speedcontrols/ac_sc_grinder/doc/README.md

## Content

- **[assembly.md](assembly.md)** - build manual.
- **[troubleshooting.md](troubleshooting.md)** - if something goes wrong.
- **[development.md](development.md)** - development & components replacement info.
- **[math.md](./math.md)** - algorithms description.
