speedcontrols/ac_sc_grinder/hal/stm32f103c8/stm32cube/README.md

Content of this folder is generated by STM32CubeMX from applied `.ioc` file.
Don't edit anything by hand!
