speedcontrols/ac_sc_grinder/doc/data/models/README.md

Scilab model of grinder motor
=============================

Model to test the formula for calculating the motor speed.

How to use:

1. Run Scilab (6.0)
2. Open `main_script.sce`
3. Set model parameters in `main_script.sce`
4. Run `main_script.sce`
5. Estimate the speed calculation error on the plot
6. Calculated speed value is also printed to the Scilab console
