speedcontrols/ac_sc_grinder/doc/images/lcsc_import.png

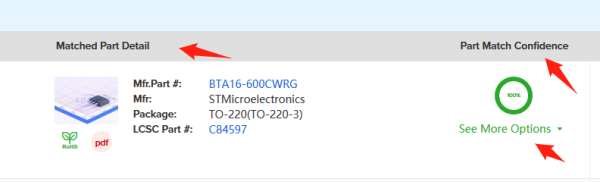
doc/images/lcsc_import.png
