speedcontrols/ac_sc_grinder/doc/images/pcb_and_case.jpg

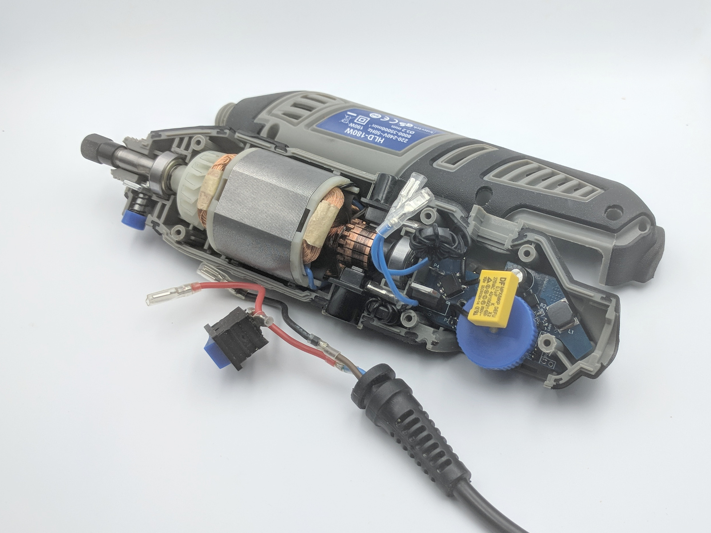
doc/images/pcb_and_case.jpg
