speedcontrols/ac_sc_grinder/doc/images/pcb_bottom.jpg

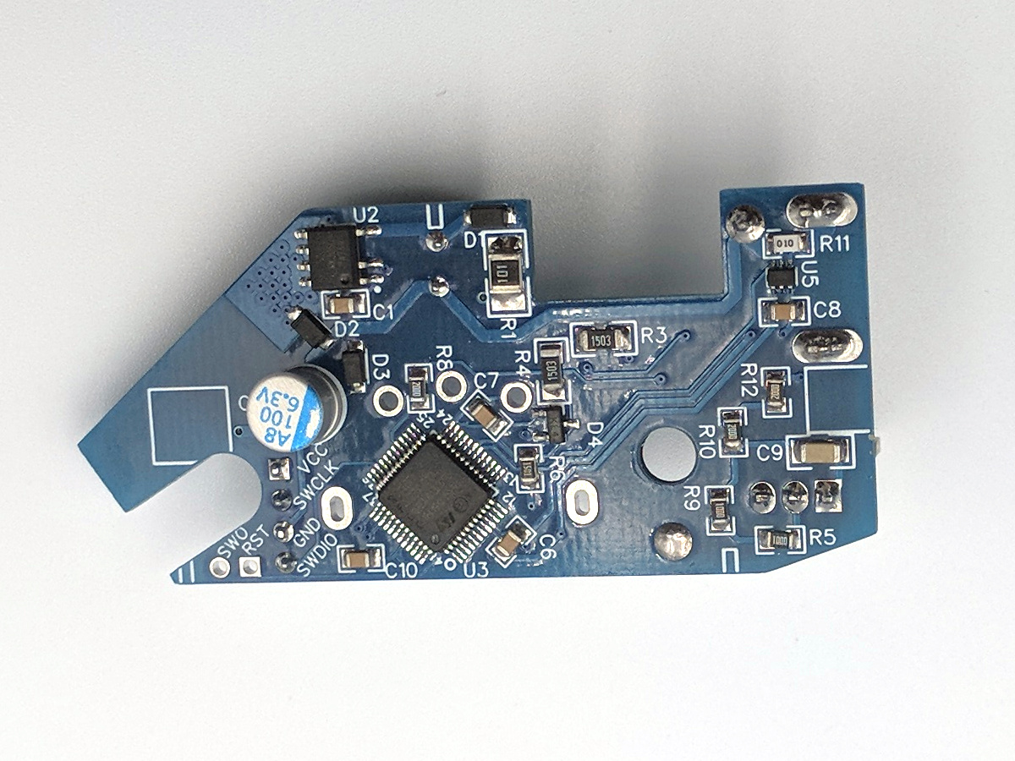
doc/images/pcb_bottom.jpg
