speedcontrols/ac_sc_grinder/doc/images/pcb_full.jpg

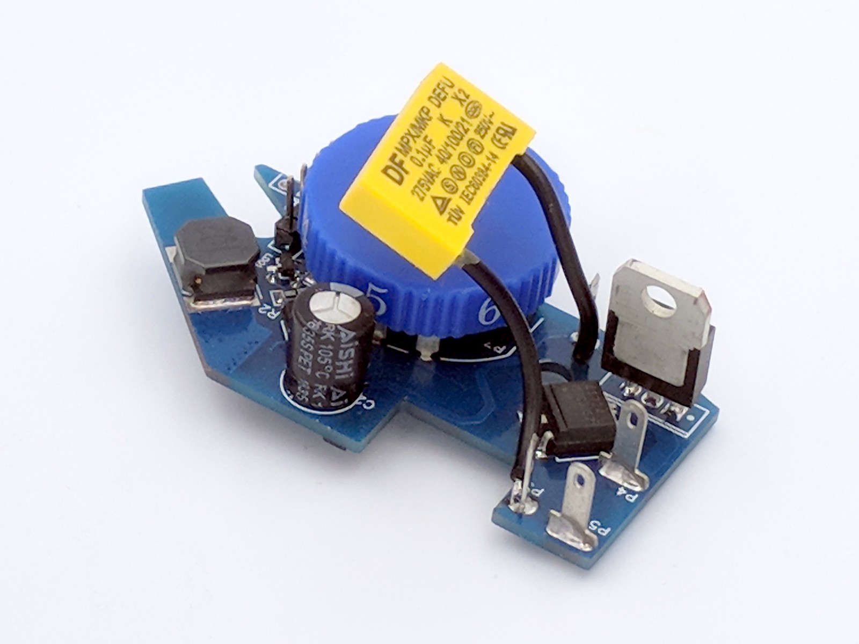
doc/images/pcb_full.jpg
