speedcontrols/ac_sc_grinder/doc/images/pcb_top.jpg

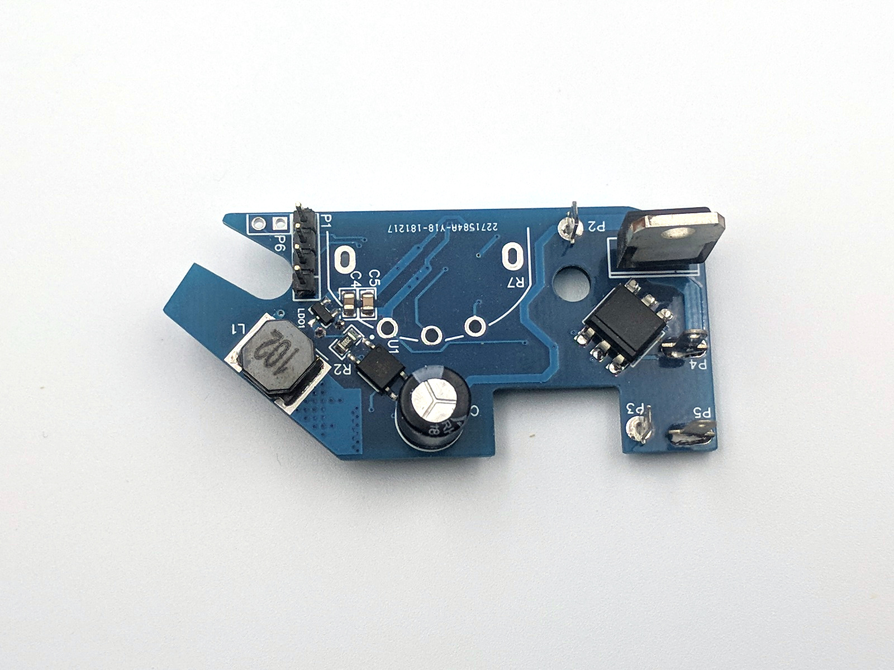
doc/images/pcb_top.jpg
