speedcontrols/ac_sc_grinder/doc/assembly.md

Device assembly <!-- omit in toc -->
===============

- [Supported grinders & PCBs](#supported-grinders--pcbs)
  - [Newacalox (red)](#newacalox-red)
  - [BDCAT (curved)](#bdcat-curved)
  - [Hilda 180W (gray) and similar](#hilda-180w-gray-and-similar)
- [Required components](#required-components)
- [Extract some parts from original board](#extract-some-parts-from-original-board)
- [Solder PCB top and bottom](#solder-pcb-top-and-bottom)
- [Cleanup PCB](#cleanup-pcb)
- [Install the rest and attach wires](#install-the-rest-and-attach-wires)
- [Upload firmware and test](#upload-firmware-and-test)
- [Cover PCB with protective coating](#cover-pcb-with-protective-coating)
- [Firmware tune](#firmware-tune)

## Supported grinders & PCBs

If you wish to customize this project, or join development, see
[dev notes](development.md).

### Newacalox (red)

- [link](https://www.aliexpress.com/item/32847620840.html)

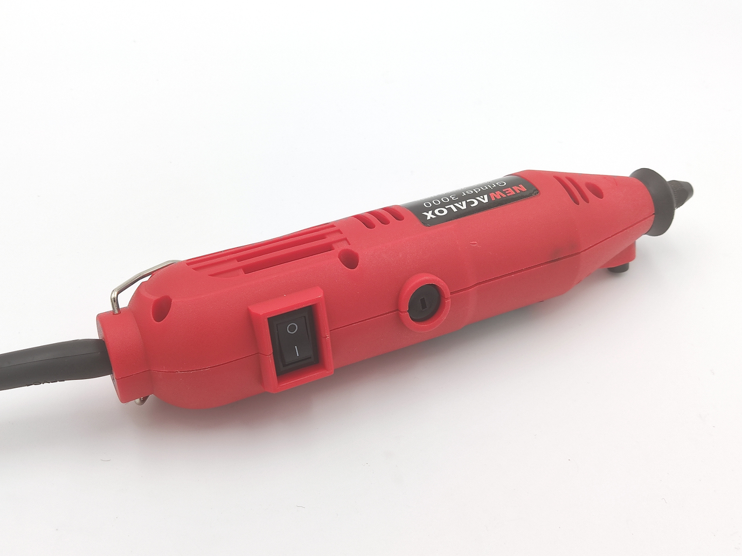
[picture p6: doc/images/grinder_newacalox.jpg]


Warning! Don't buy aqua grinders with horizontal switch placement. Those are
very similar, but need different PCB inside

PCB:

- [v4 board](https://easyeda.com/speed/ac-speed-control-v4)

### BDCAT (curved)

- [link](https://www.aliexpress.com/item/33060990933.html)

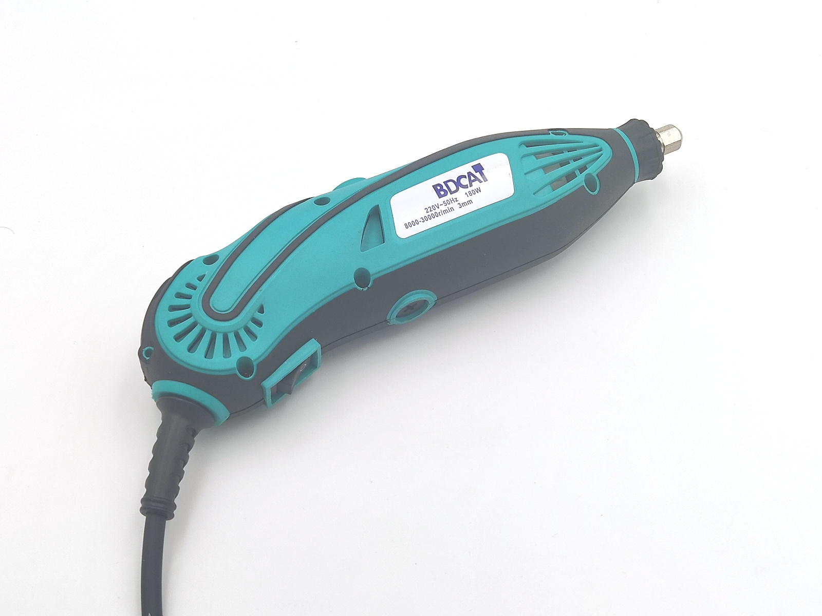
[picture p7: doc/images/grinder_bdcat.jpg]


PCB:

- [v4 board](https://easyeda.com/speed/ac-speed-control-v4)

### Hilda 180W (gray) and similar

Warning! Those grinders are out of market and not recommended for use.

- [link1](https://www.aliexpress.com/af/hilda-180w.html?SortType=total_tranpro_desc)
- [link2](https://www.banggood.com/40Pcs-180W-230V-Electric-Hand-Drill-Rotary-Tool-Mini-Electric-Grinder-Cutting-Polishing-Tools-p-1291185.html)

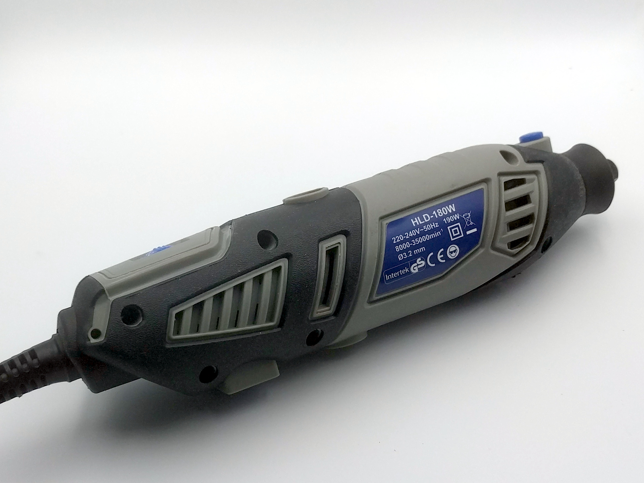
[picture p8: doc/images/grinder_hilda.jpg]


PCB:

- [v1 board](https://easyeda.com/speed/AC-speed-control-for-grinder)
- [v2 development board](https://easyeda.com/speed/ac-speed-control-v2-dev) (has
  additional interfaces, used by developers to prototype new features)

## Required components

\- | Name | Comment
-----|-------------|--------
1 | Grinder mini drill | See links above.
2 | PCB & Components | See links above, acording to your model. If you order PCB first, components second, you will be able to join delivery and save some bucks.
3 | PCB protective coating | [Plastik 70 CRC](https://www.google.com/search?q=Plastik+70+CRC) or any other acrylic [insulating lacquer](https://www.google.com/search?q=insulating+lacquer).
4 | [Male](https://www.aliexpress.com/item/32823098492.html) & [female](https://www.aliexpress.com/item/32978811645.html) 2.8x0.5mm power terminals | Optional. You can solder power wires directly.
5 | [22 AWG wire](https://www.aliexpress.com/item/1005002194439398.html) | Stainless steel / Nichrome / ... (any not too soft), for SMT stencil only. Position paste mask over PCB, via reference holes.
6 | [Cheap ST-link/V2 programmer](https://www.aliexpress.com/af/st-link-v2.html?SortType=total_tranpro_desc) | Only for boards without USB connector. You can also order it at [LCSC](https://lcsc.com/search?q=st-link) with other components.

Note, if you have soldering air gun, it's good idea to order SMT stencil to
simplify assembly. Select custom stencil, size 70*50mm & bottom layer only.

**Important!** If you order SMT stencil, add text note to your order: "**make
stencil according to paste mask file and don't forget corner holes**".

## Extract some parts from original board

Prior to disassemble, turn grinder on for 5 minutes to run-in brushes. That
will make following calibration more stable.

You need:

- Potentiometer.
- Motor terminals (optional).
- Tiac (optional, if Z0409).

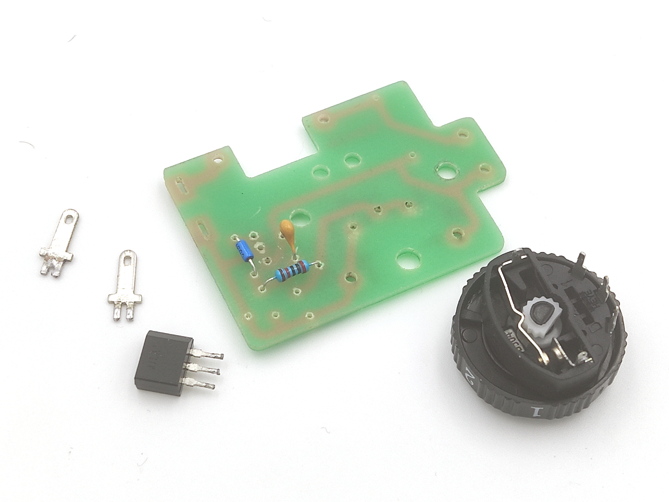
[picture p9: doc/images/old_pcb_components_newacalox.jpg]
Reused components from original Newacalox board
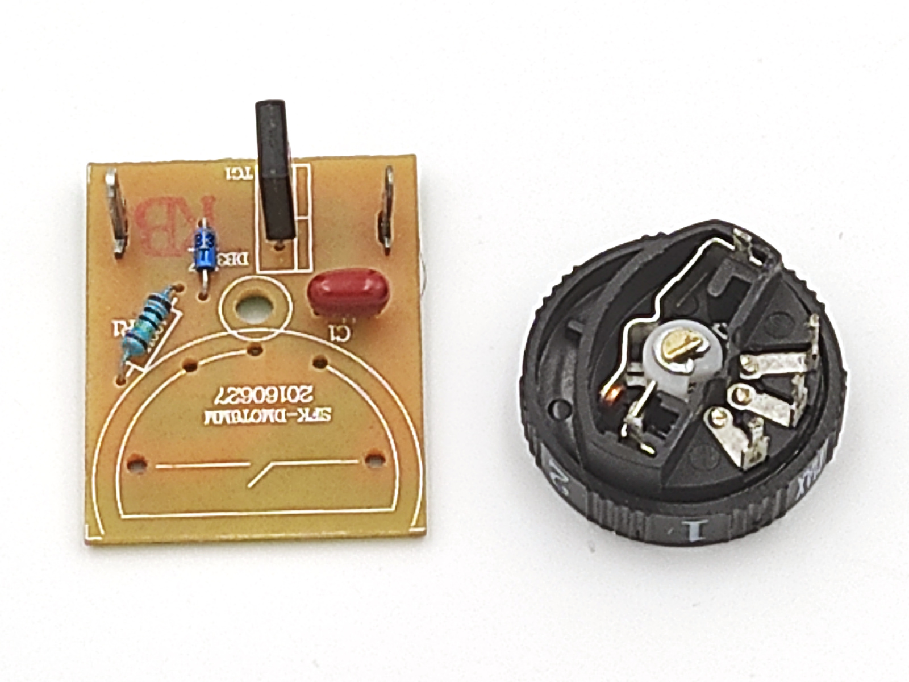
[picture p10: doc/images/old_pcb_components_bdcat.jpg]
Reused components from original BDCAT board
 

## Solder PCB top and bottom

We recommend to install all components, except regulating knob. Because on
flux cleanup phase, some solvents can wash off speed marks.

PCB bottom (Newacalox & BDCAT):

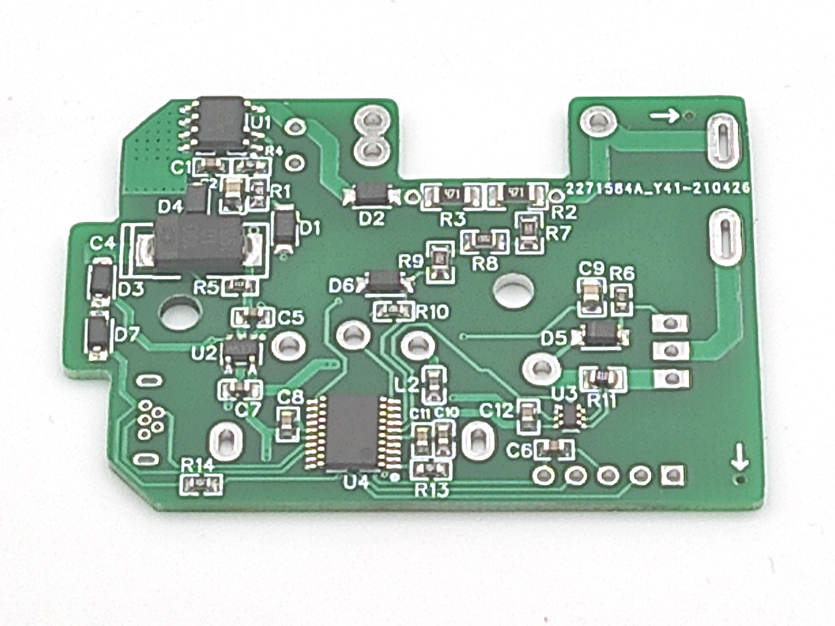
[picture p11: doc/images/pcb_v4_newacalox_bottom.jpg]
PCB bottom side (Newacalox)
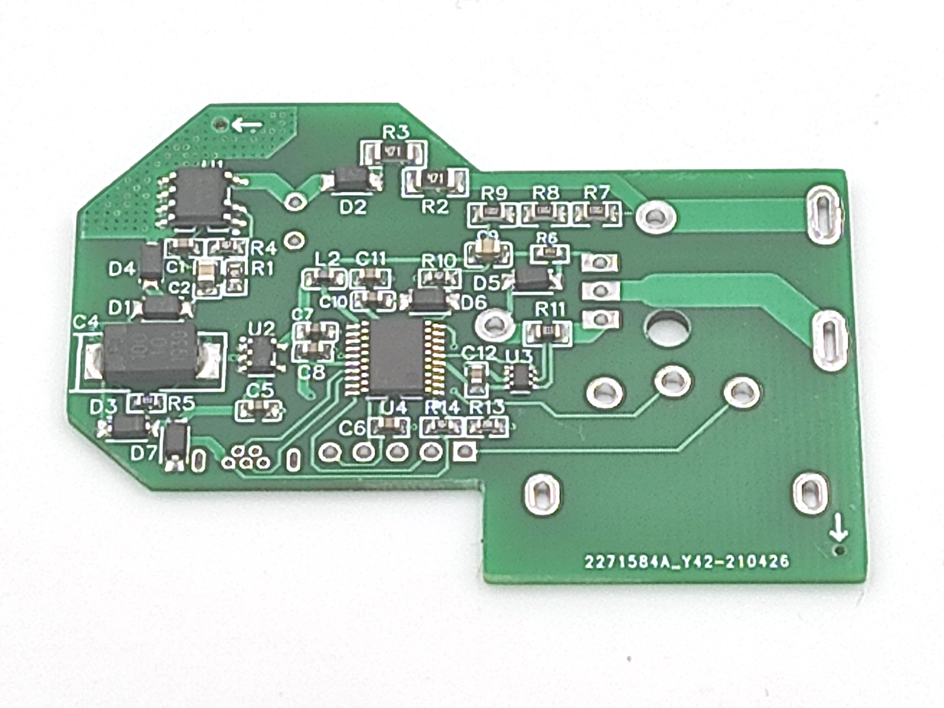
[picture p12: doc/images/pcb_v4_bdcat_bottom.jpg]
PCB bottom side (BDCAT)
 

PCB top (Newacalox & BDCAT):

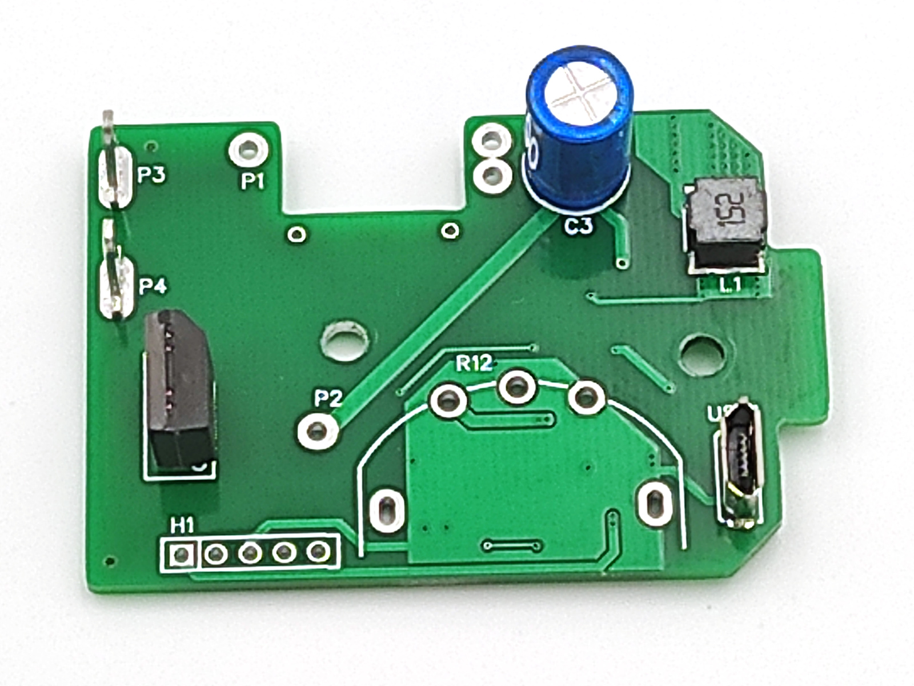
[picture p13: doc/images/pcb_v4_newacalox_top.jpg]
PCB top side (Newacalox)
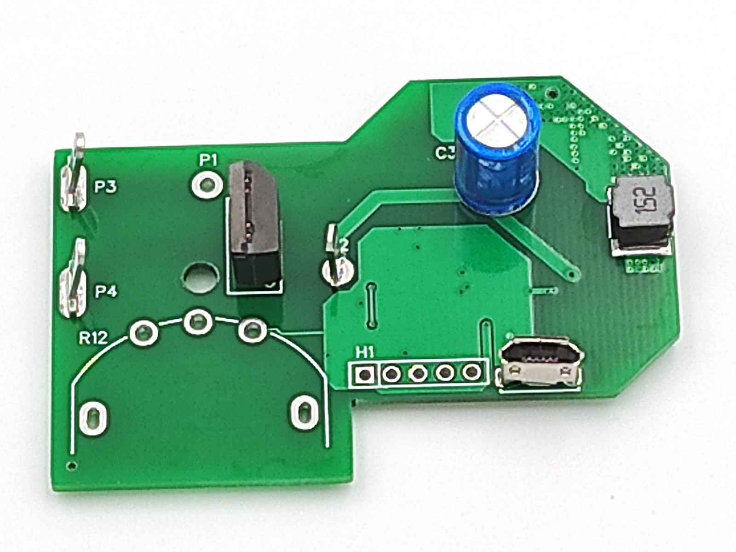
[picture p14: doc/images/pcb_v4_bdcat_top.jpg]
PCB top side (BDCAT)
 

## Cleanup PCB

You should remove the rest of flux, to add protective coating later. We recommend
use ultrasonic bath (small ones are cheap).

## Install the rest and attach wires

Now you can install potentiometer, and check everything fits into case.
Don't forget to remove flux again.

PCB with speed knob:

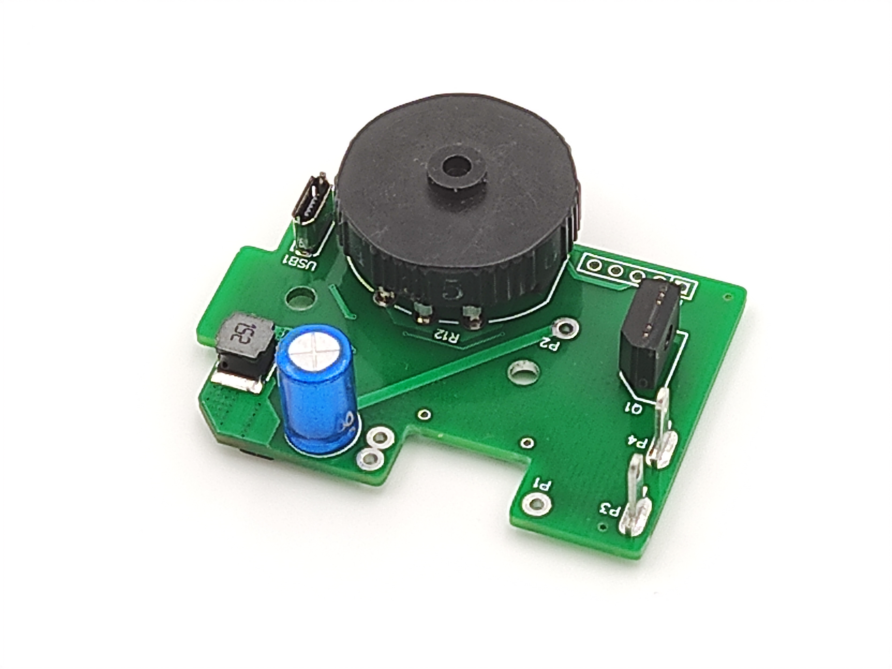
[picture p15: doc/images/pcb_v4_newacalox_full.jpg]
PCB with all components (Newacalox)
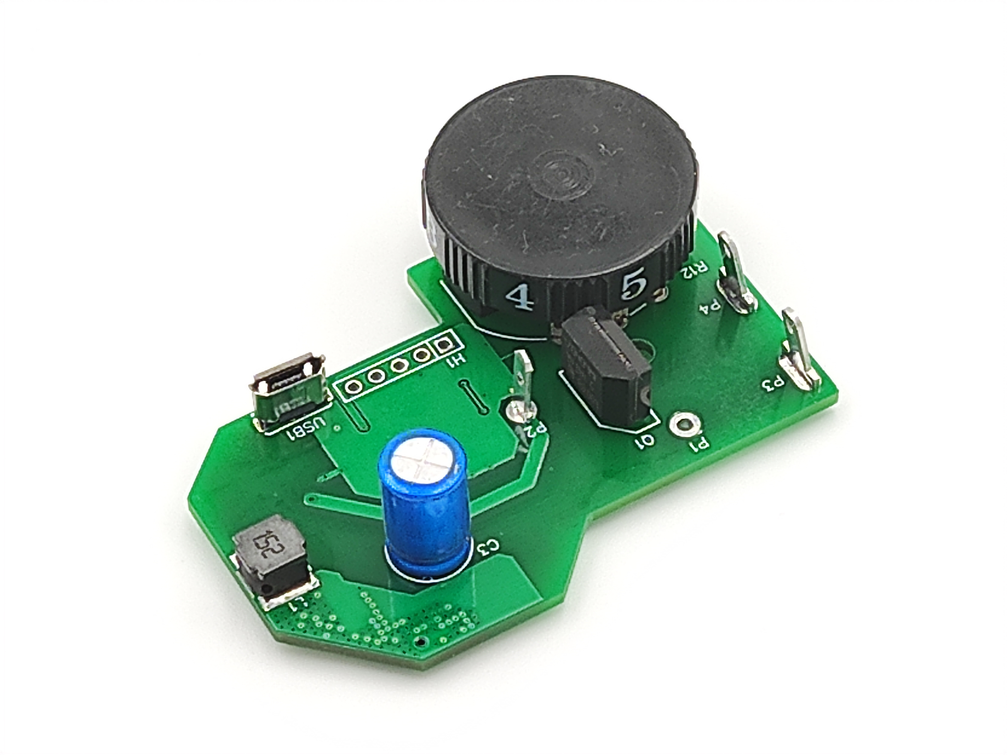
[picture p16: doc/images/pcb_v4_bdcat_full.jpg]
PCB with all components (BDCAT)
 

PCB in drill body:

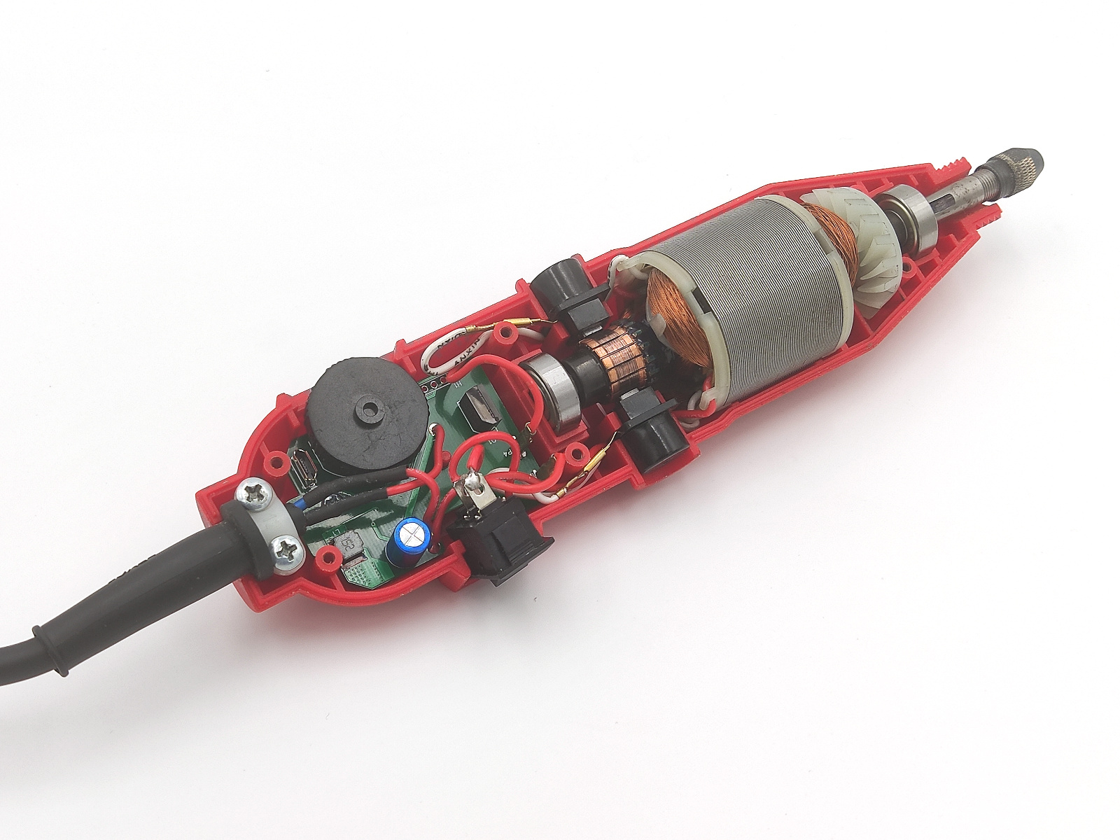
[picture p17: doc/images/pcv_v4_in_case_newacalox.jpg]
PCB in case
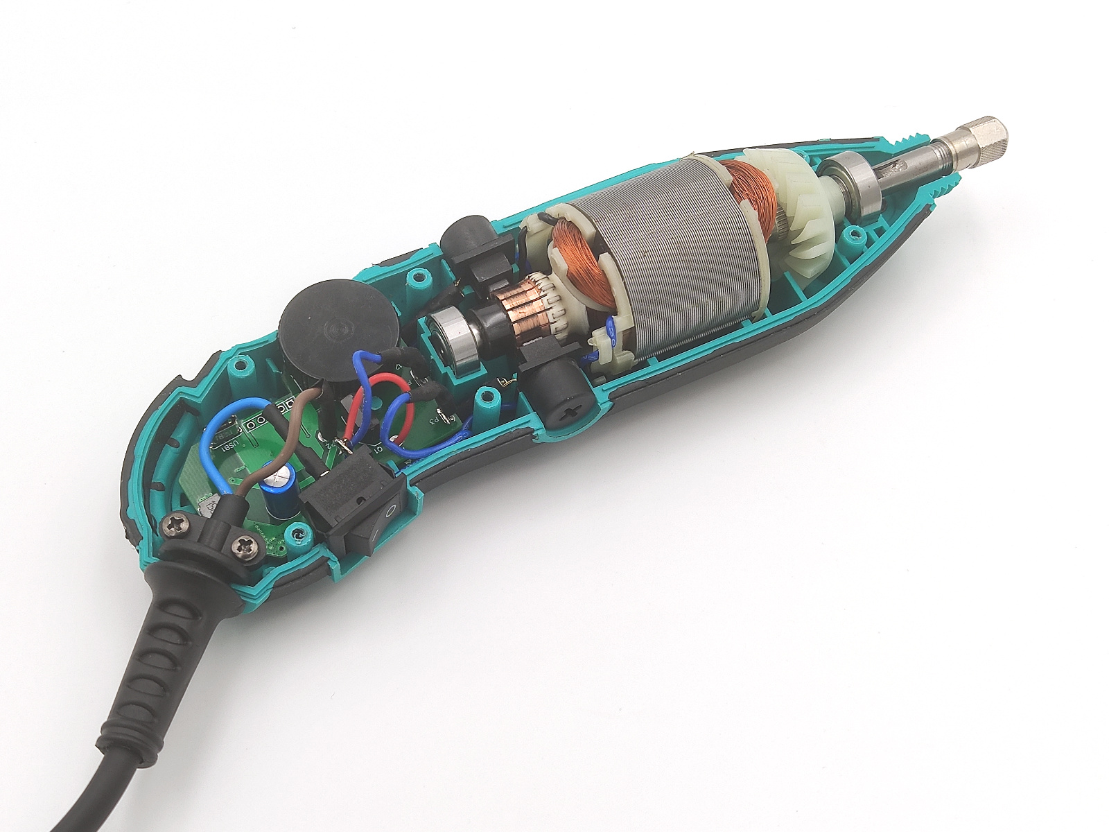
[picture p18: doc/images/pcv_v4_in_case_bdcat.jpg]
PCB in case
 

## Upload firmware and test

**WARNING! You MUST unplug power cord prior to firmware upload.** Turning power
off via grinder switch is not enough. If you plug programmer into computer
while AC plug in power socket, your USB interface may be damaged!

1. Install [VS Code](https://code.visualstudio.com/).
2. Clone this repo or download as zip archive and unpack somewhere.
3. Open folder with project AND after VS Code suggests to install plugins - agree
   with everything. That should install PlatformIO and all required dependencies.
4. Make sure you installed & configured ST-link/V2 drivers:
   - [Linux](http://docs.platformio.org/en/latest/installation.html#troubleshooting)
     instructions (how to configure `udev` rules).
   - [Windows](https://www.st.com/en/development-tools/stsw-link009.html) drivers.
5. Attach USB cable or ST-link/V2 programmer (depends on your board).
6. In VS Code, click PlatformIO tab, expand `env:...` item with matching
   MCU/programmer and click `Upload` (see image blow). Then wait until complete.

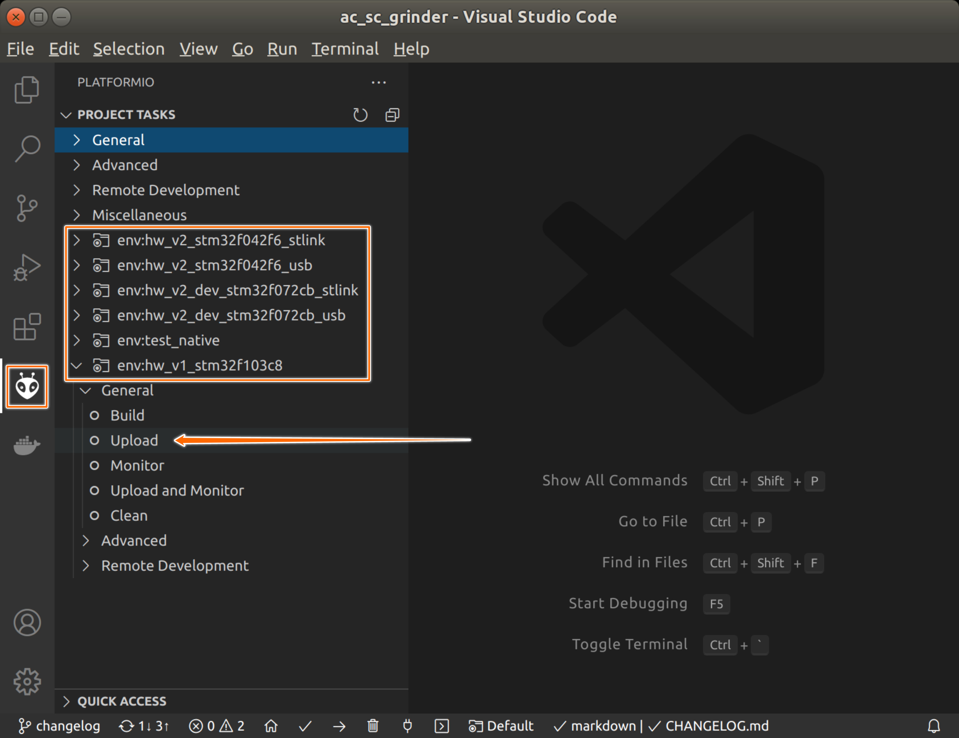
[picture p19: doc/images/plaformio_uploader.jpg]
VSCode upload firmware


Now you can assemble drill, run self-calibration and try how your "new drill"
works.

**IMPORTANT**. When you turn device on after firmware upload, motor will run at
slow speed and will not react on knob. That means, motor calibration required
(it's done only once, don't worry).

To run calibration:

- Move knob to zero.
- Move knob shortly up-and-down 3 times (in 3 seconds).
- Wait couple of minutes until magic finishes and motor stops. Be patient.

If everything works as needed, you can go to final step - protect PCB from dust.
Or see [troubleshooting](troubleshooting.md) if something goes wrong.

## Cover PCB with protective coating

When you work, drill is actively cooled with air flow. Produced dust can be
partially absorbed and cause regulator damage. It's strongly recommended to
shield PCB with protective coating.

**Warning!** Coating should be done after you are 100% sure everything
works as expected. You will not be able to solder PCB after that.

Prior to apply coating, don't forget to clean PCB with isopropyl alcohol or
acetone. That's important for good adhesion.

You can use special PCB coatings or alternatives. See below.

### Special PCB coatings <!-- omit in toc -->

Such products are "officially" declared as suitable for PCB protection. This
can be spray like [Plastik 70 CRC](https://www.google.com/search?q=Plastik+70+CRC),
acrylic [insulating lacquer](https://www.google.com/search?q=insulating+lacquer),
or something else.

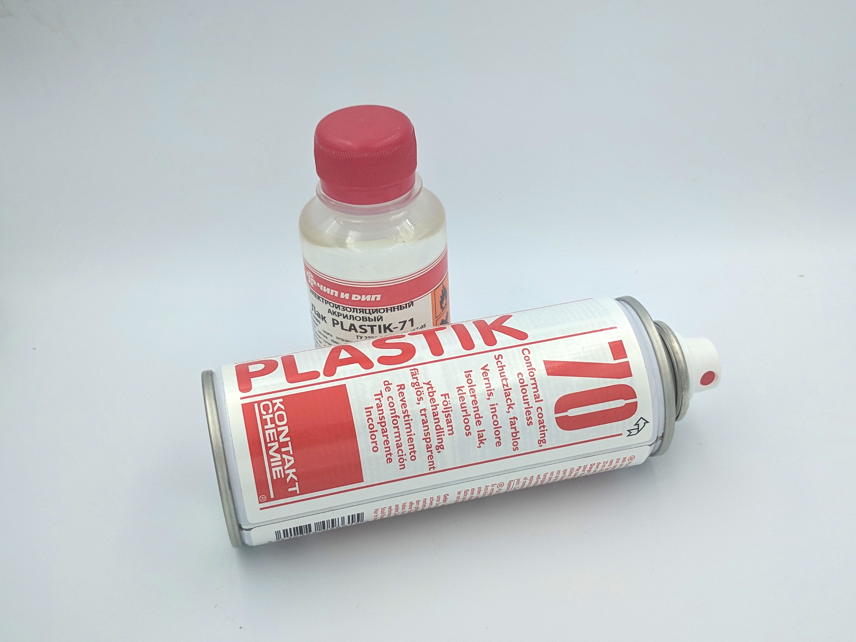
[picture p20: doc/images/protective_coat.jpg]
Protective coat in spray and liquid form


If your coater is spray - put it to pepsi cap first and use cosmetic brush to
cover PCB. Don't apply spray directly, because you need to keep terminals and
knob internals clean.

Usually, lacquers need 3-5 layers for best result.

Note, a lot of ordinary lacquers from your local shop can be ok. BUT,
some may have not suitable electric resistance. Don't use untested things, if
you are not 100% sure. See more safe alternatives below.

### Alternate protection <!-- omit in toc -->

If you have no special PCB chemistry, it may be more convenient to find
alternate & more cheap materials in your local shop.

**RTV1 non-corrosive silicon glues:**

- [RTV704](https://aliexpress.com/af/704-silicone-glue.html)
- [RTV705](https://aliexpress.com/af/705-silicone-glue.html)

IMPORTANT! You should not use any random silicone glue, because those can
contain acid. Advised glues were tested and are neutral.

Disadvantage: all silicone glues need 1 day to dry.

**UV gels for nails**

Those have more weak adhesion to PCB, than previous recipes. But this method may
be more simple/accessible for you. At least, that's better than nothing :).

NOTE. You should NOT use any random gel!

- It should have good adhesion to PCB.
- It should be "top coating" (good durability).
- It should be marked as "soak off" / "no wipe" and so on.

After testing adhesion of different samples, those look nice:

- [MIZHSE Rubber Top Coat](https://www.aliexpress.com/item/32922287804.html) -
  preferable.
- [UR SUGAR Top Coat](https://www.aliexpress.com/item/32948364351.html) - may
  be more viscous than desired for comfortable work.

Disadvantage: average adhesion, not tested in long term (months and years).

## Firmware tune

By default, auto-tune tries to do the best, and you should not need manual
modifications. But, there are some rare cases, when you may wish to change
defaults.

If grinder "oscillates" in some modes - reduce [`ADRC_SAFETY_SCALE`](https://github.com/speedcontrols/ac_sc_grinder/blob/master/src/calibrator/calibrator_adrc.h#L25) to `0.5`. Value should be as max as possible.

## The end :) <!-- omit in toc -->

Enjoy!
