speedcontrols/ac_sc_grinder/doc/data/r_calibration.ods

Setpoint % | R_motor, Ohm | R_motor (raw)
0,1 | 169,288162231445 | 11094469
0,15 | 123,165817260742 | 8071795
0,2 | 106,43391418457 | 6975253
0,3 | 92,3887023925781 | 6054786
0,4 | 89,2661743164063 | 5850148
0,6 | 89,9062042236328 | 5892093
1 | 89,9062042236328 | 5892093
