speedcontrols/ac_sc_grinder/(threads)

Thread 1 (2018-08-19):

Dev memo

puzrin, 2018-08-19:
This issue contains list if ideas, left aside due time constrains. Probably, those are completely useless :)

- Soft start. Not sure this is needed too much.
- Better current limits under heavy load. Not sure this is needed.

puzrin, 2020-05-22:
# Alternate models

PCB was routed for "Hilda-180W"- like models (gray body). Those are going out of market, being replaced with new models. Here is list of alernate models with enough room for PCB.

## Most interesting

Different labels but the same case:

- BDCAT https://www.aliexpress.com/item/33060990933.html
- Hilda https://www.aliexpress.com/item/33034410246.html

Just 15-20$, nice.

## Alternate

- Hilda https://www.aliexpress.com/item/32584194830.html

More expensive and more rare.

Thread 4 (2020-09-28):

Project with 500W Hilda grinder,

Viusonic, 2020-09-28:

puzrin, 2020-09-28:
IMO it's better use gitter chat for such questions.

All errors i know were due bad solder or reversed current amplifier. Is output of INA213 correct?

Closed 2020-10-03.

Thread 5 (2021-07-28):

Change ADRC calibration setpoint

puzrin, 2021-07-28:
Need to calibrate ADRC at minimal setpoint, to reach stability in full range.

1. Set voltage to max, and normalize speed to calculate desired minimal one.
2. Iterate voltage to reach minimal speed.
3. Run ADRC at that speed.

puzrin, 2021-08-07:
https://github.com/speedcontrols/ac_sc_grinder/commit/09e1c93afe1c49bb50e1c1f0c1df778042afe465

puzrin, 2022-04-23:
@olegkapitonov i've lost your contacts, please write me to telegram/email

Closed 2021-08-07.

Thread 7 (2023-03-22):

HW: MP157

kimstik, 2023-03-22:
I'm afraid the MP157 is not pin compatible with the LNK3204.

Few more notes:
It is better to indicate that C7 is rated for at least 400 V.
I may [not recommend](https://www.mikrocontroller.net/search?query=LNK304+defekt) to use LNK30x.
You can also look at the [RL10](https://ww1.microchip.com/downloads/en/DeviceDoc/SR10%20B080613.pdf) as coil-free way.

puzrin, 2023-03-22:
That's all in the past.

1. MP157 has a separate PCB version and is not recommended to use due to bad availability
2. Latest PCB should use LNK320x. Schematic has appropriate notes.
3. Coil-free chips like RL10 have a big turn-on time (several seconds), which is not acceptable for the concrete use case.

Also note, this project is quite old. New one is https://github.com/speedcontrols/dc_sc_grinder, but it still has no working firmware (draft only).

kimstik, 2023-03-24:
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

My point to upgrade old Hilda with working solution.

MP157 stuff is not so clear:
[/doc/development.md](https://github.com/speedcontrols/ac_sc_grinder/blob/8f356d63a9e19cb0ab96740df264dba7830b99a6/doc/development.md)
```
LNK3204 replacement
You can use LNK304 or MP157, but you should update feedback resistors (according to chip datasheet) to make output 4.0-4.2 volts.
```

Description/schematics mismatch here:
https://oshwlab.com/speed/ac-speed-control-v2-dev

[dc_sc_grinder](https://github.com/speedcontrols/dc_sc_grinder) have same issue of "non-marking" voltage rating of HV caps.
It can be confusing for newbies.

Closed 2023-03-22.

Thread 8 (2023-08-12):

Wanted: Dremel Digital 400 PCB

kimstik, 2023-08-12:
I have an old hand grinder with dead caps.
"Dremel Digital 400" 140 W, 230 V, 5.000 - 33.000 rpm, LCD
It will be cool to give him second life with better control.
