speedcontrols/ac_sc_grinder/src/app.h

#ifndef __APP_H__
#define __APP_H__

#include <stdint.h>

float eeprom_float_read(uint32_t addr, float dflt);
void eeprom_float_write(uint32_t addr, float val);

#include "io.h"

extern Io io;

#include "meter.h"

extern Meter meter;

#include "regulator_adrc.h"

extern Regulator regulator;

#endif
