speedcontrols/ac_sc_grinder/src/calibrator/calibrator_adrc.h

#ifndef __CALIBRATOR_ADRC__
#define __CALIBRATOR_ADRC__

#include "../math/fix16_math.h"
#include "../app.h"

#include <limits.h>
#include <cmath>
#include "etl/cyclic_value.h"

// Minimal reasonable adrc_Kp * b0 value
#define MIN_ADRC_KPdivB0 0.3
// Minimal adrc_Kobservers value (observers disabled)
#define MIN_ADRC_KOBSERVERS 0.0
// Safe adrc_Kobservers value for adrc_Kp calibration
#define SAFE_ADRC_KOBSERVERS 1.0
// Minimal adrc_p_corr_coeff is 0 (proportional correction disabled)
#define MIN_ADRC_P_CORR_COEFF 0.0

#define INIT_KP_ITERATION_STEP 4.0
#define INIT_OBSERVERS_ITERATION_STEP 4.0
#define INIT_P_CORR_COEFF_ITERATION_STEP 5.0

// Scale down ADRC coefficients to this value for safety
#define ADRC_SAFETY_SCALE 0.6
#define ADRC_P_CORR_COEFF_SAFETY_SCALE 0.6

// Maximal setpoint for picking motor speed factor
#define SPEED_FACTOR_SETPOINT 0.8

// Maximum speed oscillation amplitude
// and speed overshoot values
// for ADRC_KP and ADRC_KOBSERVERS adjustment
#define MAX_AMPLITUDE 3.0
// Maximum speed oscillation amplitude
// and speed overshoot values
// for ADRC_P_CORR_COEFF adjustment
#define MAX_P_CORR_COEFF_AMPLITUDE 3.0
#define MAX_OVERSHOOT 0.15

// Setpoint values for start and
// stop time measurement.
#define LOW_SPEED_SETPOINT 0.35
#define HIGH_SPEED_SETPOINT 0.7

// Speed data is noisy, so start/stop
// time is measured when speed crosses
// SPEED_MEASURE_THRESHOLD and then recalculated
// to more narrow SPEED_IDEAL_THRESHOLD.
#define SPEED_MEASURE_THRESHOLD 0.15
#define SPEED_IDEAL_THRESHOLD 0.02

// Assume that motor is 1-st order dynamic system.
// It will cross SPEED_IDEAL_THRESHOLD
// at ideal time = measured time * start_stop_adjust
static const fix16_t start_stop_adjust = fix16_from_float(
  (float)(log(SPEED_IDEAL_THRESHOLD) / log(SPEED_MEASURE_THRESHOLD))
);

// Frequency scale for data save when measure start/stop time.
// Helps to save used memory
#define SPEED_DATA_SAVE_RATIO 10

// Max 10 seconds to store data on start/stop time measure
#define SPEED_DATA_SAVE_TIME_MAX 10

// Lowpass coefficient value
// LOWPASS_FC - cutoff frequency, Hz
// LOWPASS_FD - sampling frequency, Hz
#define LOWPASS_FC 5.0
#define LOWPASS_FS 50.0
#define LOWPASS_FILTER_ALPHA ((2.0 * M_PI / LOWPASS_FS * LOWPASS_FC) \
                              / (2.0 * M_PI / LOWPASS_FS * LOWPASS_FC + 1.0))

class CalibratorADRC {
public:

    bool tick(io_data_t &io_data) {
        YIELDABLE;

        //
        // Before start time measure motor must run at steady low speed
        //

        io.setpoint = F16(LOW_SPEED_SETPOINT);
        speed_tracker.reset();

        while (!speed_tracker.is_stable_or_exceeded())
        {
            YIELD(false);
            if (!io_data.zero_cross_up) continue;

            speed_tracker.push(meter.speed);
        }

        //
        // Apply high speed power and record process of speed rise,
        // until speed become stable
        //

        io.setpoint = F16(HIGH_SPEED_SETPOINT);
        speed_tracker.reset();
        speed_data_idx = 0;
        start_time_ticks = 0;
        start_stop_scaler_cyclic_cnt = 0;

        while (!speed_tracker.is_stable_or_exceeded())
        {
            YIELD(false);
            start_time_ticks++;
            if (!io_data.zero_cross_up) continue;

            if (speed_data_idx < speed_data_length)
            {
                // Apply lowpass filtration
                filtered_speed = fix16_mul(
                    F16(LOWPASS_FILTER_ALPHA),
                    meter.speed
                ) + fix16_mul(
                    F16(1.0 - LOWPASS_FILTER_ALPHA),
                    (speed_data_idx == 0) ? meter.speed : filtered_speed
                );

                if (start_stop_scaler_cyclic_cnt++ == 0) {
                    start_speed_data[speed_data_idx++] = filtered_speed;
                }
            }

            speed_tracker.push(meter.speed);
        }

        start_speed_data_len = speed_data_idx;

        //
        // Now measure stop time (reverse process)
        //

        io.setpoint = F16(LOW_SPEED_SETPOINT);
        speed_tracker.reset();
        speed_data_idx = 0;
        stop_time_ticks = 0;
        start_stop_scaler_cyclic_cnt = 0;

        while (!speed_tracker.is_stable_or_exceeded())
        {
            YIELD(false);
            stop_time_ticks++;
            if (!io_data.zero_cross_up) continue;

            if (speed_data_idx < speed_data_length)
            {
                // Apply lowpass filtration
                filtered_speed = fix16_mul(
                    F16(LOWPASS_FILTER_ALPHA),
                    meter.speed
                ) + fix16_mul(
                    F16(1.0 - LOWPASS_FILTER_ALPHA),
                    (speed_data_idx == 0) ? meter.speed : filtered_speed
                );

                if (start_stop_scaler_cyclic_cnt++ == 0) {
                    stop_speed_data[speed_data_idx++] = filtered_speed;
                }
            }

            speed_tracker.push(meter.speed);
        }

        stop_speed_data_len = speed_data_idx;

        motor_start_stop_time = calculate_start_stop_time(
            start_speed_data_len,
            start_speed_data,
            stop_speed_data_len,
            stop_speed_data
        );

        //
        // Pick motor scaling factor
        //

        // Reset scaling factor
        meter.cfg_rekv_to_speed_factor = fix16_one;
        io.setpoint = F16(SPEED_FACTOR_SETPOINT);

        speed_tracker.reset();

        // At setpoint=1.0 motor may work unstable
        // due to heavy sparking at the commutator
        // So measure at setpoint=0.8 and then
        // linearly extrapolate
  
        // Wait for stable speed
        while (!speed_tracker.is_stable_or_exceeded())
        {
          YIELD(false);
          if (!io_data.zero_cross_up) continue;
            speed_tracker.push(meter.speed);
        }

        // Extrapolate measured value to setpoint=1.0
        float speed_factor = fix16_to_float(fix16_div(speed_tracker.average(),
          F16(SPEED_FACTOR_SETPOINT)));
        
        eeprom_float_write(
          CFG_REKV_TO_SPEED_FACTOR_ADDR,
          speed_factor
        );

        meter.configure();

        //
        // Calculate speed setting values for picking ADRC regulator parameters
        //

        fix16_t cfg_rpm_max_limit = fix16_from_float(
          eeprom_float_read(CFG_RPM_MAX_LIMIT_ADDR, CFG_RPM_MAX_LIMIT_DEFAULT)
        );

        fix16_t cfg_rpm_min_limit = fix16_from_float(
          eeprom_float_read(CFG_RPM_MIN_LIMIT_ADDR, CFG_RPM_MIN_LIMIT_DEFAULT)
        );

        fix16_t rpm_min_rel = fix16_div(cfg_rpm_min_limit, cfg_rpm_max_limit);

        adrc_kp_speed_setting = rpm_min_rel;
        adrc_observers_speed_setting = rpm_min_rel;
        adrc_p_corr_coeff_speed_setting = rpm_min_rel;

        //
        // Pick ADRC_KP coeff value by half cut method
        //

        iterations_count = 0;

        regulator.cfg_adrc_p_corr_coeff = F16(MIN_ADRC_P_CORR_COEFF);

        adrc_param_attempt_value = fix16_div(F16(MIN_ADRC_KPdivB0),
                                             regulator.adrc_b0_inv);

        // TODO - Measure period duration for correct operation at 50 and 60 Hz
        measure_amplitude_ticks_max = fix16_to_int(motor_start_stop_time * 50);

        iteration_step = fix16_div(F16(INIT_KP_ITERATION_STEP),
                                   regulator.adrc_b0_inv);

        // Set ADRC_KOBSERVERS to safe value
        regulator.cfg_adrc_Kobservers = F16(SAFE_ADRC_KOBSERVERS);

        while (iterations_count < max_iterations)
        {
            speed_tracker.reset();

            // Wait for stable speed with minimal
            // ADRC_KP and safe ADRC_KOBSERVERS
            regulator.cfg_adrc_Kp = fix16_div(F16(MIN_ADRC_KPdivB0),
                                              regulator.adrc_b0_inv);
            regulator.adrc_update_observers_parameters();

            while (!speed_tracker.is_stable_or_exceeded())
            {
                regulator.tick(adrc_kp_speed_setting, meter.speed);
                io.setpoint = regulator.out_power;

                YIELD(false);
                if (!io_data.zero_cross_up) continue;

                speed_tracker.push(meter.speed);
            };

            //
            // Measure amplitude
            //

            regulator.cfg_adrc_Kp = adrc_param_attempt_value;
            regulator.adrc_update_observers_parameters();

            measure_amplitude_max_speed = 0;
            measure_amplitude_min_speed = fix16_maximum;
            measure_amplitude_ticks = 0;
            median_filter.reset();
            ticks_cnt = 0;

            while (measure_amplitude_ticks < measure_amplitude_ticks_max)
            {
                regulator.tick(adrc_kp_speed_setting, meter.speed);
                io.setpoint = regulator.out_power;

                YIELD(false);
                if (!io_data.zero_cross_up) continue;

                ticks_cnt++;
                median_filter.add(meter.speed);

                if (ticks_cnt >= 12)
                {
                    fix16_t filtered_speed = median_filter.result();
                    median_filter.reset();
                    ticks_cnt = 0;

                    if (measure_amplitude_max_speed < filtered_speed)
                    {
                        measure_amplitude_max_speed = filtered_speed;
                    }
                    if (measure_amplitude_min_speed > filtered_speed)
                    {
                        measure_amplitude_min_speed = filtered_speed;
                    }
                }

                measure_amplitude_ticks++;
            }

            fix16_t amplitude = measure_amplitude_max_speed - measure_amplitude_min_speed;

            // Save amplitude of first iteration as reference
            // to compare values of next iterations to this value
            if (iterations_count == 0) first_iteration_amplitude = amplitude;

            // If amplitude is less than margin value
            // step for next iteration should be positive,
            // otherwise - negative
            if (amplitude <= fix16_mul(first_iteration_amplitude, F16(MAX_AMPLITUDE)))
            {
                iteration_step = abs(iteration_step);
            }
            else iteration_step = -abs(iteration_step);

            adrc_param_attempt_value += iteration_step;

            iteration_step /= 2;
            iterations_count++;

        }

        adrc_kp_calibrated_value = fix16_mul(adrc_param_attempt_value, F16(ADRC_SAFETY_SCALE));

        //
        // Pick ADRC_KOBSERVERS coeff value by half cut method
        //

        iterations_count = 0;
        adrc_param_attempt_value = F16(MIN_ADRC_KOBSERVERS);
        
        // TODO - Measure period duration for correct operation at 50 and 60 Hz
        measure_amplitude_ticks_max = fix16_to_int(motor_start_stop_time * 50);

        iteration_step = F16(INIT_OBSERVERS_ITERATION_STEP);

        // Set ADRC_KP to calibrated value
        regulator.cfg_adrc_Kp = adrc_kp_calibrated_value;

        while (iterations_count < max_iterations)
        {
            speed_tracker.reset();

            // Wait for stable speed with calibrated
            // ADRC_KP and minimal ADRC_KOBSERVERS
            regulator.cfg_adrc_Kobservers = F16(MIN_ADRC_KOBSERVERS);
            regulator.adrc_update_observers_parameters();

            while (!speed_tracker.is_stable_or_exceeded())
            {
                regulator.tick(adrc_observers_speed_setting, meter.speed);
                io.setpoint = regulator.out_power;

                YIELD(false);
                if (!io_data.zero_cross_up) continue;

                speed_tracker.push(meter.speed);
            };

            //
            // Measure amplitude
            //

            regulator.cfg_adrc_Kobservers = adrc_param_attempt_value;
            regulator.adrc_update_observers_parameters();

            measure_amplitude_max_speed = 0;
            measure_amplitude_min_speed = fix16_maximum;
            measure_amplitude_ticks = 0;
            median_filter.reset();
            ticks_cnt = 0;

            while (measure_amplitude_ticks < measure_amplitude_ticks_max)
            {
                regulator.tick(adrc_observers_speed_setting, meter.speed);
                io.setpoint = regulator.out_power;

                YIELD(false);
                if (!io_data.zero_cross_up) continue;

                ticks_cnt++;
                median_filter.add(meter.speed);

                if (ticks_cnt >= 12)
                {
                    fix16_t filtered_speed = median_filter.result();
                    median_filter.reset();
                    ticks_cnt = 0;

                    if (measure_amplitude_max_speed < filtered_speed)
                    {
                        measure_amplitude_max_speed = filtered_speed;
                    }
                    if (measure_amplitude_min_speed > filtered_speed)
                    {
                        measure_amplitude_min_speed = filtered_speed;
                    }
                }

                measure_amplitude_ticks++;
            }

            fix16_t amplitude = measure_amplitude_max_speed - measure_amplitude_min_speed;

            // Save amplitude of first iteration as reference
            // to compare values of next iterations to this value
            if (iterations_count == 0) first_iteration_amplitude = amplitude;

            // If amplitude is less than margin value
            // step for next iteration should be positive,
            // otherwise - negative
            if (amplitude <= fix16_mul(first_iteration_amplitude, F16(MAX_AMPLITUDE)))
            {
                iteration_step = abs(iteration_step);
            }
            else iteration_step = -abs(iteration_step);

            adrc_param_attempt_value += iteration_step;

            iteration_step /= 2;
            iterations_count++;

        }

        adrc_observers_calibrated_value = fix16_mul(adrc_param_attempt_value, F16(ADRC_SAFETY_SCALE));

        //
        // Pick ADRC_P_CORR_COEFF value by half cut method
        //

        iterations_count = 0;
        adrc_param_attempt_value = F16(MIN_ADRC_P_CORR_COEFF);

        // TODO - Measure period duration for correct operation at 50 and 60 Hz
        measure_amplitude_ticks_max = fix16_to_int(motor_start_stop_time * 50);

        iteration_step = F16(INIT_P_CORR_COEFF_ITERATION_STEP);

        // Set ADRC_KP and ADRC_KOBSERVERS to calibrated values
        regulator.cfg_adrc_Kp = adrc_kp_calibrated_value;
        regulator.cfg_adrc_Kobservers = adrc_observers_calibrated_value;
        regulator.adrc_update_observers_parameters();

        while (iterations_count < max_iterations)
        {
            speed_tracker.reset();

            // Wait for stable speed with calibrated
            // ADRC_KP, calibrated ADRC_KOBSERVERS
            // and minimal ADRC_P_CORR_COEFF
            regulator.cfg_adrc_p_corr_coeff = F16(MIN_ADRC_P_CORR_COEFF);

            while (!speed_tracker.is_stable_or_exceeded())
            {
                regulator.tick(adrc_p_corr_coeff_speed_setting, meter.speed);
                io.setpoint = regulator.out_power;

                YIELD(false);
                if (!io_data.zero_cross_up) continue;

                speed_tracker.push(meter.speed);
            };

            //
            // Measure amplitude
            //

            regulator.cfg_adrc_p_corr_coeff = adrc_param_attempt_value;

            measure_amplitude_max_speed = 0;
            measure_amplitude_min_speed = fix16_maximum;
            measure_amplitude_ticks = 0;
            median_filter.reset();
            ticks_cnt = 0;

            while (measure_amplitude_ticks < measure_amplitude_ticks_max)
            {
                regulator.tick(adrc_p_corr_coeff_speed_setting, meter.speed);
                io.setpoint = regulator.out_power;

                YIELD(false);
                if (!io_data.zero_cross_up) continue;

                ticks_cnt++;
                median_filter.add(meter.speed);

                if (ticks_cnt >= 12)
                {
                    fix16_t filtered_speed = median_filter.result();
                    median_filter.reset();
                    ticks_cnt = 0;

                    if (measure_amplitude_max_speed < filtered_speed)
                    {
                        measure_amplitude_max_speed = filtered_speed;
                    }
                    if (measure_amplitude_min_speed > filtered_speed)
                    {
                        measure_amplitude_min_speed = filtered_speed;
                    }
                }

                measure_amplitude_ticks++;
            }

            fix16_t amplitude = measure_amplitude_max_speed - measure_amplitude_min_speed;

            // Save amplitude of first iteration as reference
            // to compare values of next iterations to this value
            if (iterations_count == 0) first_iteration_amplitude = amplitude;

            // If amplitude is less than margin value
            // step for next iteration should be positive,
            // otherwise - negative
            if (amplitude <= fix16_mul(first_iteration_amplitude, F16(MAX_P_CORR_COEFF_AMPLITUDE)))
            {
                iteration_step = abs(iteration_step);
            }
            else iteration_step = -abs(iteration_step);

            adrc_param_attempt_value += iteration_step;

            iteration_step /= 2;
            iterations_count++;

        }

        adrc_p_corr_coeff_calibrated_value = fix16_mul(adrc_param_attempt_value, F16(ADRC_P_CORR_COEFF_SAFETY_SCALE));

        //
        // Store results
        //

        eeprom_float_write(
            CFG_ADRC_KP_ADDR,
            fix16_to_float(adrc_kp_calibrated_value)
        );
        eeprom_float_write(
            CFG_ADRC_KOBSERVERS_ADDR,
            fix16_to_float(adrc_observers_calibrated_value)
        );
        eeprom_float_write(
            CFG_ADRC_P_CORR_COEFF_ADDR,
            fix16_to_float(adrc_p_corr_coeff_calibrated_value)
        );

        //
        // Reload config & flush garbage after unsync, caused by long EEPROM write.
        //
        regulator.configure();
        meter.reset_state();

        return true;
    }

private:

    // Desireable accuracy of ADRC calibration is 0.1
    // We need 7 iterations to achieve this accuracy
    // because (10 - 1)/2^7 = 0.07 < 0.1
    enum {
        max_iterations = 7
    };

    int ticks_cnt = 0;

    // Holds buffer length for start/stop time calculation
    enum {
        speed_data_length = (int)(SPEED_DATA_SAVE_TIME_MAX * 60 / SPEED_DATA_SAVE_RATIO)
    };

    // Speed settings for picking ADRC regulator parameters
    fix16_t adrc_kp_speed_setting;
    fix16_t adrc_observers_speed_setting;
    fix16_t adrc_p_corr_coeff_speed_setting;

    // Buffers for speed data for start/stop
    // time measurement
    fix16_t start_speed_data[speed_data_length];
    fix16_t stop_speed_data[speed_data_length];
    int speed_data_idx = 0;
    int start_time_ticks = 0;
    int stop_time_ticks = 0;
    etl::cyclic_value<uint32_t, 0, SPEED_DATA_SAVE_RATIO - 1> start_stop_scaler_cyclic_cnt;
    fix16_t filtered_speed = 0;

    fix16_t prev_speed = 0;

    int start_speed_data_len;
    int stop_speed_data_len;

    fix16_t adrc_param_attempt_value;

    fix16_t adrc_kp_calibrated_value;
    fix16_t adrc_observers_calibrated_value;
    fix16_t adrc_p_corr_coeff_calibrated_value;

    fix16_t iteration_step;

    fix16_t measure_amplitude_max_speed;
    fix16_t measure_amplitude_min_speed;

    // Holds value calculated during first attempt
    fix16_t first_iteration_amplitude;

    int iterations_count = 0;

    // History of measured speed. Used to detect stable values.
    // At 50Hz ~ 0.25s for single fetch, 9s timeout
    StabilityFilterTemplate<F16(2.0), 12, 12*39, 6> speed_tracker;

    int measure_attempts = 0;

    MedianIteratorTemplate<fix16_t, 32> median_filter;
    fix16_t motor_start_stop_time;

    int measure_amplitude_ticks = 0;
    int measure_amplitude_ticks_max;

    // Measure steady state speed with safe ADRC parameters
    // during 3 sec interval
    enum {
        measure_steadystate_ticks_max = 50*3
    };

    fix16_t overshoot_speed = 0;
    fix16_t steadystate_speed = 0;

    // Returns sum of start and stop times
    fix16_t calculate_start_stop_time(
        int start_len,
        fix16_t start_data[],
        int stop_len,
        fix16_t stop_data[]
    )
    {
        fix16_t start_steady_speed = start_data[start_len - 1];
        fix16_t start_initial_speed = start_data[0];
        fix16_t speed_at_measure_threshold = fix16_mul(
            start_steady_speed,
            F16(1.0 - SPEED_MEASURE_THRESHOLD)
        ) + fix16_mul(
            start_initial_speed,
            F16(SPEED_MEASURE_THRESHOLD)
        );

        fix16_t start_time_measured = 0;

        for (int i = 0; i < start_len; i++)
        {
            if (start_data[i] > speed_at_measure_threshold)
            {
                start_time_measured = fix16_from_float((float)(i * start_time_ticks) / (float)(start_len *  APP_TICK_FREQUENCY));
                break;
            }
        }

        fix16_t stop_steady_speed = stop_data[stop_len - 1];
        fix16_t stop_initial_speed = stop_data[0];
        speed_at_measure_threshold = fix16_mul(
            stop_steady_speed,
            F16(1.0 - SPEED_MEASURE_THRESHOLD)
        ) + fix16_mul(
            stop_initial_speed,
            F16(SPEED_MEASURE_THRESHOLD)
        );

        fix16_t stop_time_measured = 0;

        for (int i = 0; i < stop_len; i++)
        {
            if (stop_data[i] < speed_at_measure_threshold)
            {
                stop_time_measured = fix16_from_float((float)(i * stop_time_ticks) / (float)(stop_len  * APP_TICK_FREQUENCY));
                break;
          }
        }

        fix16_t start_stop_time_measured = start_time_measured + stop_time_measured;

        // Assume that motor is 1-st order dynamic system,
        // calculate time when it will cross SPEED_IDEAL_THRESHOLD
        fix16_t start_stop_time = fix16_mul(
            start_stop_time_measured,
            start_stop_adjust
        );

        return start_stop_time;
    }
};

#endif
