speedcontrols/ac_sc_grinder/src/calibrator/calibrator.h

#ifndef __CALIBRATOR_H__
#define __CALIBRATOR_H__

// Detect when user dials knob 3 times, start calibration sequence and
// update configuration.

#include "math/fix16_math.h"
#include "yield.h"

#include "../app.h"
#include "calibrator_wait_knob_dial.h"
#include "calibrator_static.h"
#include "calibrator_adrc.h"


class Calibrator
{
public:

    // Returns:
    //
    // - false: we should continue in normal mode
    // - true:  calibration started, we should stop other actions in main
    //          loop until finished.
    //
    bool tick(io_data_t &io_data) {
        YIELDABLE;

        YIELD_UNTIL(wait_knob_dial.tick(io_data), false);
        YIELD_UNTIL(calibrate_static.tick(io_data), true);
        YIELD_UNTIL(calibrate_adrc.tick(io_data), true);

        return false;
    }

private:
    // Nested FSM-s
    CalibratorWaitKnobDial wait_knob_dial;
    CalibratorStatic calibrate_static;
    CalibratorADRC calibrate_adrc;
};

#endif
