speedcontrols/ac_sc_grinder/(commit log)

2018-10-02 Math docs
    [r_l_calibration_100_percents.ods, r_l_calibration_10_percents.ods, r_l_calibration_15_percents.ods, rpms_approximated.ods, rpms_vs_volts_idling.ods, speed_noise.ods, voltage_and_current.ods]
2018-11-09 Add pid calibration
2018-12-05 Add start/stop time calibration
2018-12-09 Docs: PID calibration, links to more articles, typos
2019-01-08 Refactor PID calibration
2019-01-24 PID: simplify calibration algorythm
    - Use min/max in P/I trackers
    - Drop data buffers
2019-01-25 docs: pid calibration algorythm update
2019-04-06 Move stability filter to separate file
2019-04-07 Force speed to low constant value until R calibrated
2019-04-14 Fix -Wconvert warnings and related errors
    [app.cpp, calibrator_static.h, calibrator_wait_knob_dial.h, eeprom_emu.h]
2019-04-26 Docs: added calibration info and R compensation algorythm
2019-06-06 doc: update R & RMP calibration figures
    [r_calibration.ods, r_l_calibration_100_percents.ods, r_l_calibration_10_percents.ods, r_l_calibration_15_percents.ods, rpms_approximated.ods]
2019-06-28 Add EasyEDA project archive for previous PCB version
2019-08-01 doc: add LCSC BOM import notes
2020-04-28 Improve PID_I calibration
2020-06-10 Rework PID mode switch
2020-06-27 hal: stm32f070 => stm32f072
2020-09-15 Refactor R calibration & tune FP scales in Meter
2020-09-18 tune ADC frequency
2020-09-19 Move negative voltage emulation to io & realign math scale
2020-09-19 Added STM32F042F6 hal
2020-09-23 Added dev board photos
2020-10-02 Add PID correction to have idle speed voltage when divergence is zero
2020-10-02 Add guards to reverse voltage & triac
    [app_hal.cpp]
2020-10-03 Use short pulses to switch triac on.
    [io.h]
2020-10-13 Fix power treshold value in calibrator.
    [calibrator_static.h]
2021-02-25 Improve noise filter & avoid zero division
    [app.cpp, calibrator_noise.h, calibrator_static.h, meter.h]
2021-02-25 hal: set stm32f042 adc frequency equal to stm32f072
2021-02-25 Add ADRC regulator
2021-08-01 Drop PID support
2021-08-06 Calibrate regulator at minimum speed
2021-08-06 Add new boards info
2021-08-12 doc: add ADRC regulator and calibration math
